Jens-Langen/letterbox/README.md

# letterbox
Smarter Briefkasten

Details: http://www.langen.koeln/wp/?p=11
