Jens-Langen/letterbox/Eagle/briefkasten_brd.png

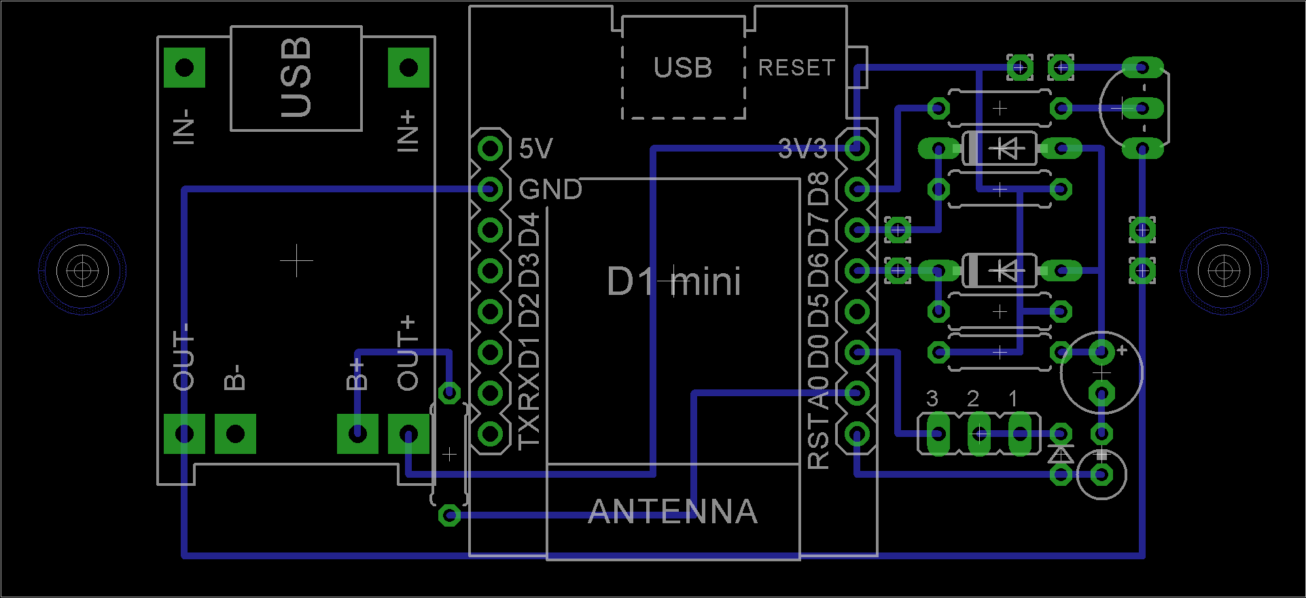
Eagle/briefkasten_brd.png
