Jens-Langen/letterbox/Eagle/briefkasten_sch.png

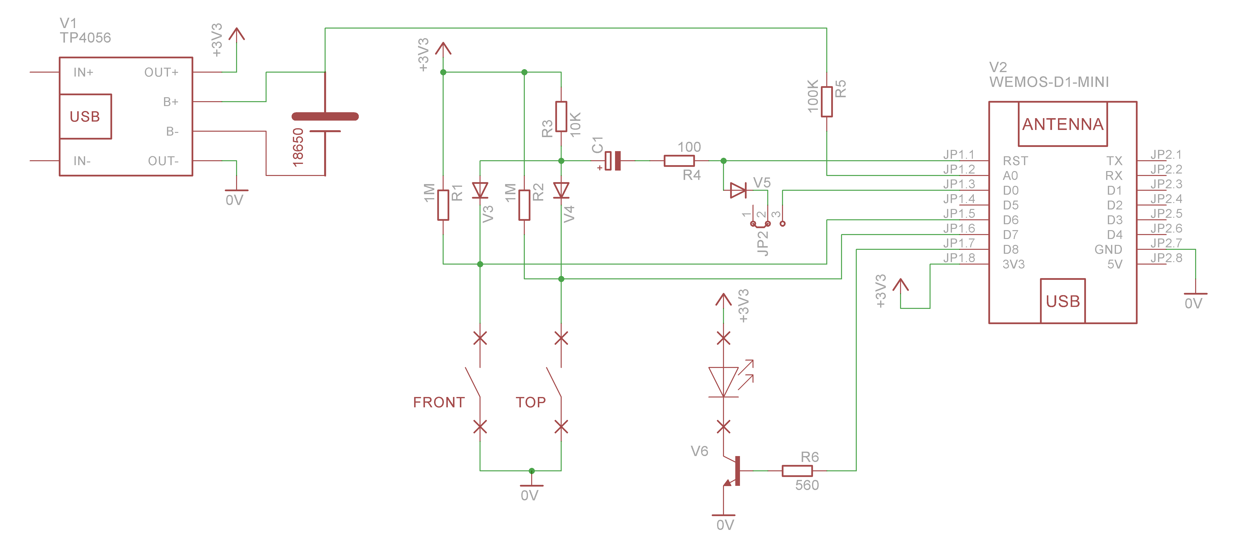
Eagle/briefkasten_sch.png
