Jens-Langen/letterbox/ioBroker/letter.gif

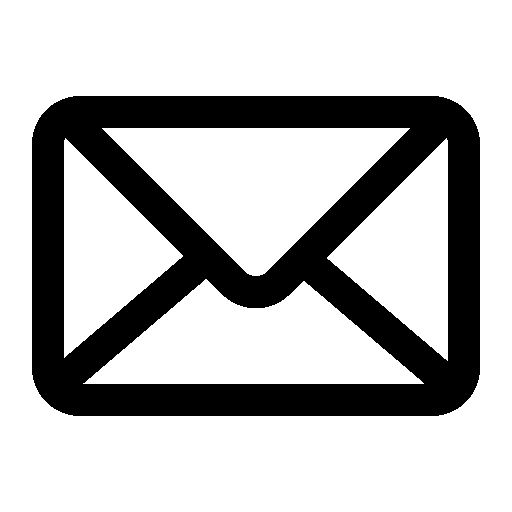
ioBroker/letter.gif
