Jens-Langen/letterbox/stl/bohr_lehre.stl

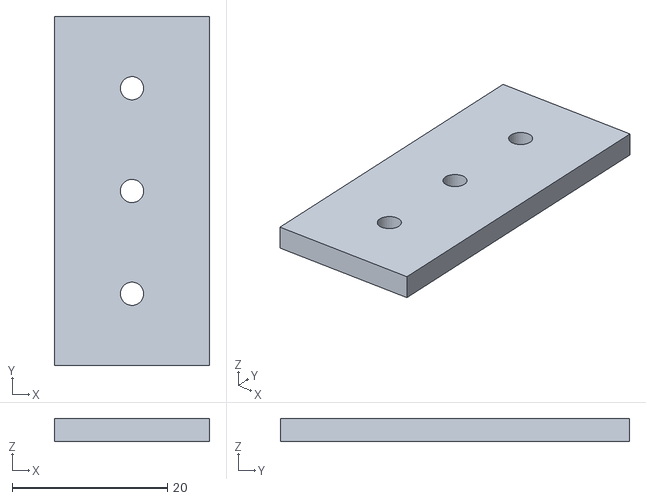
[picture p4: CAD file, 2019-02-04]
stl/bohr_lehre.stl
20.0 x 45.0 x 3.00
