Jens-Langen/letterbox/stl/Gehaeuse_unterteil.stl

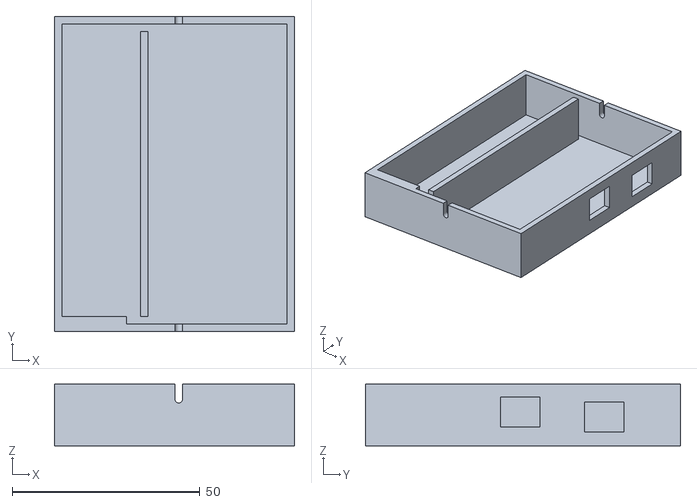
[picture p5: CAD file, 2019-02-04]
stl/Gehaeuse_unterteil.stl
64.0 x 84.0 x 16.4
