Jens-Langen/letterbox/stl/Stoessel.stl

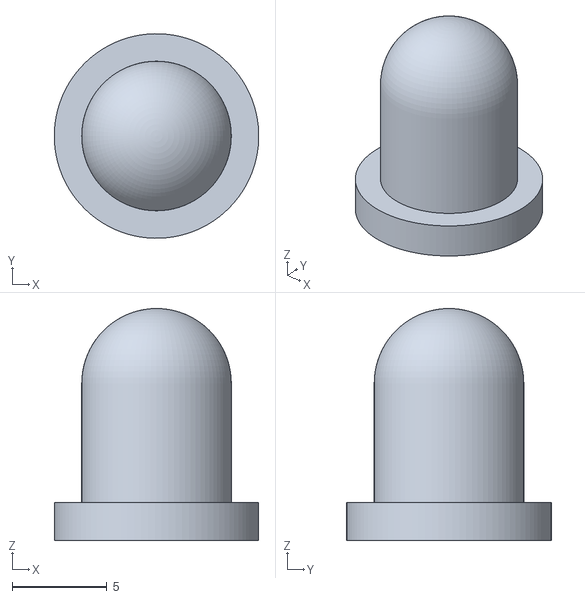
[picture p6: CAD file, 2019-02-04]
stl/Stoessel.stl
10.8 x 10.8 x 12.3
