Jens-Langen/letterbox/stl/Gehauese_deckel.stl

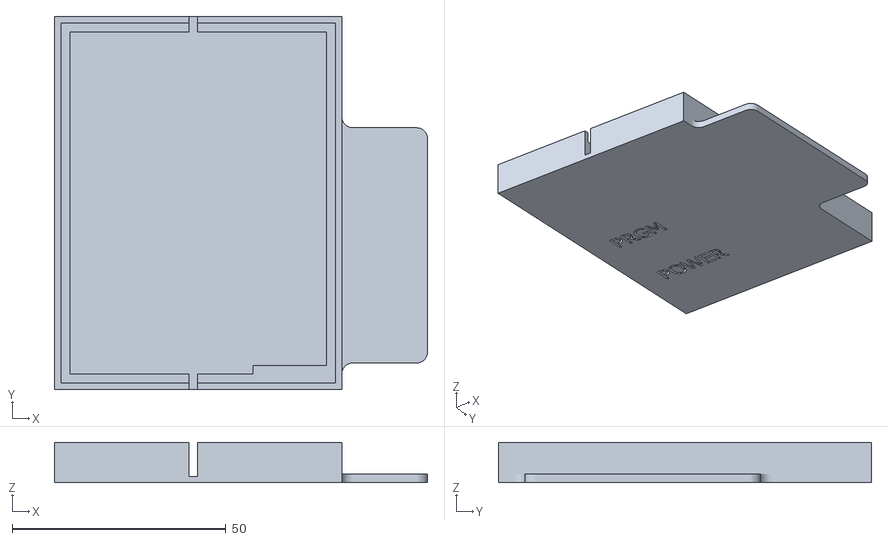
[picture p7: CAD file, 2019-02-04]
stl/Gehauese_deckel.stl
87.2 x 87.2 x 9.40
