Jens-Langen/letterbox/stl/halter2.stl

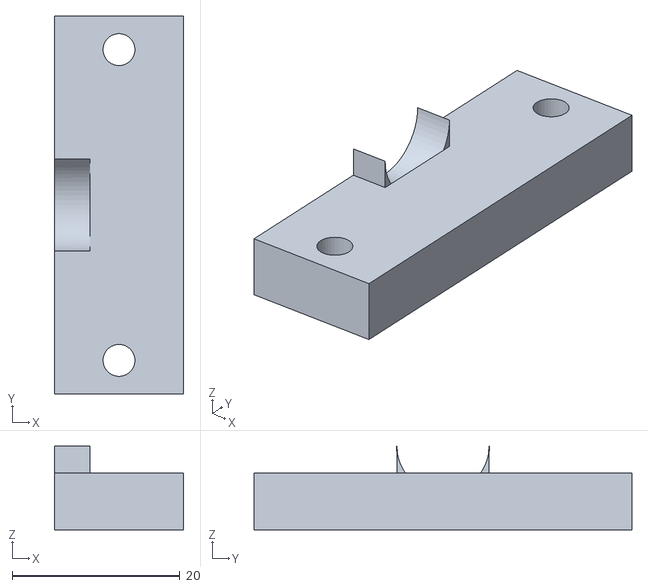
[picture p8: CAD file, 2019-02-04]
stl/halter2.stl
15.4 x 45.0 x 10.0
