Jens-Langen/letterbox/stl/schalter_Halter.stl

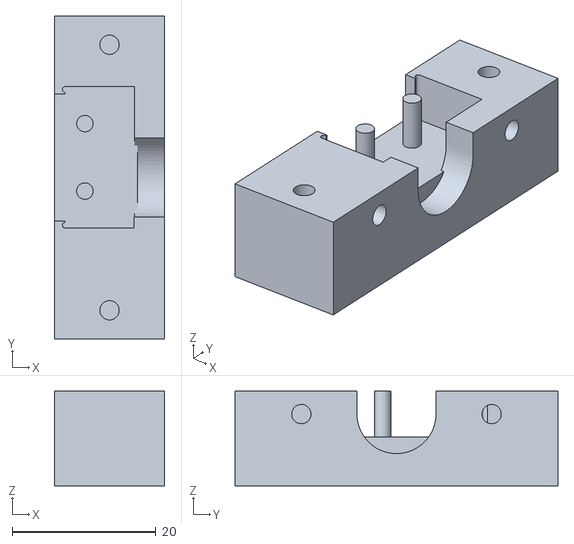
[picture p9: CAD file, 2019-02-04]
stl/schalter_Halter.stl
15.4 x 45.0 x 13.2
