Jens-Langen/letterbox/stl/deckel.stl

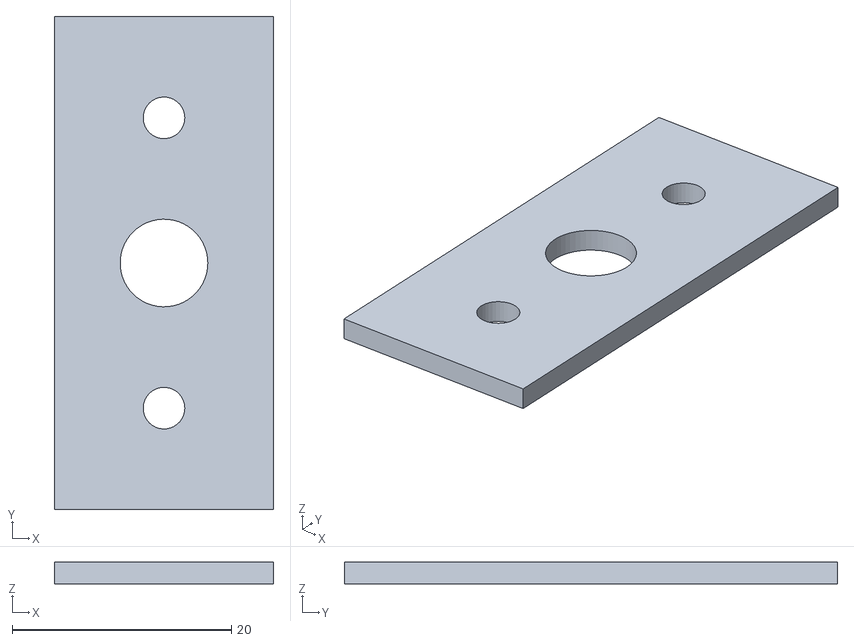
[picture p10: CAD file, 2019-02-04]
stl/deckel.stl
20.0 x 45.0 x 2.00
