Jens-Langen/letterbox/stl/abstandshalter.stl

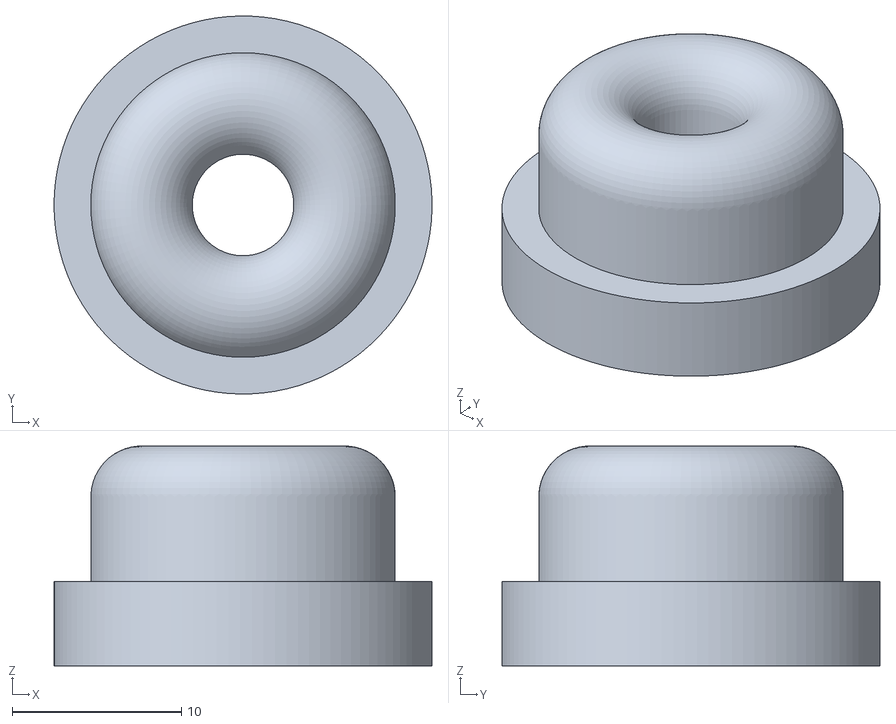
[picture p11: CAD file, 2019-02-04]
stl/abstandshalter.stl
22.3 x 22.3 x 13.0
