Jens-Langen/letterbox/Eagle/briefkasten.brd

## EAGLE design Eagle/briefkasten.brd (2019-02-04)

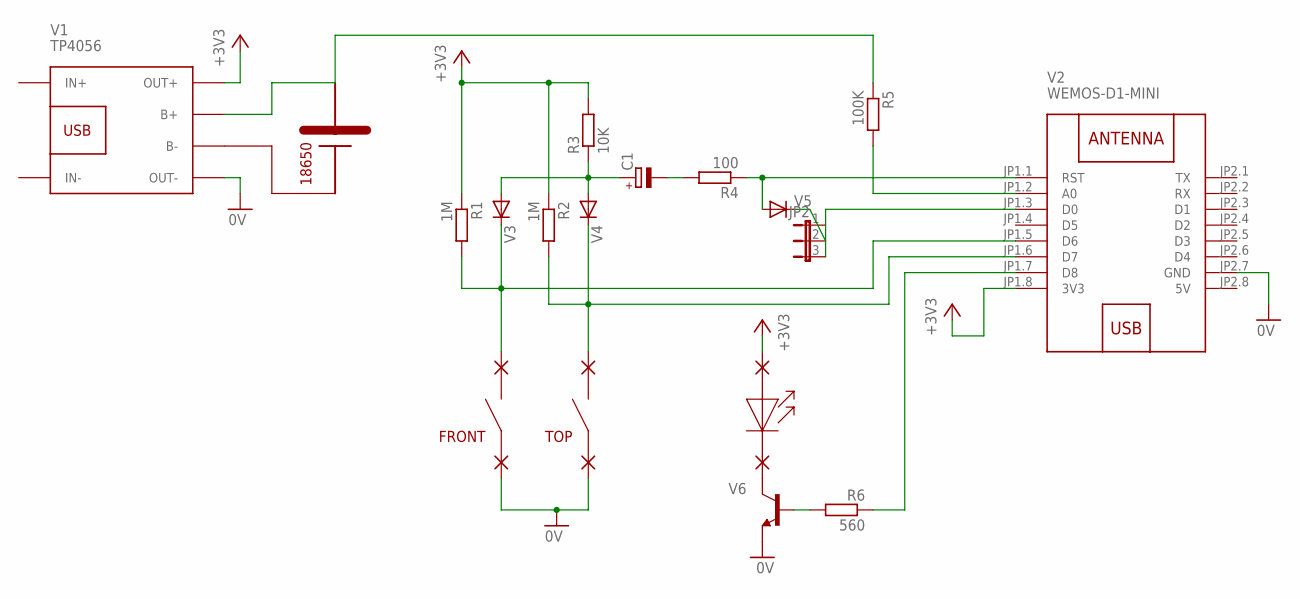
[picture p12: schematic briefkasten.sch]

Parts:
C1: CPOL-EUE2.5-5; E2,5-5
JP2: JP2E; JP2
PAD7, PAD8, PAD9, PAD10, PAD11, PAD12: 1,6/0,9
R1, R2: 1M; 0207/7
R3: 10K; 0207/7
R4: 100; 0309V
R5: 100K; 0207/7
R6: 560; 0207/7
V1: TP4056; BATTERY-CHARGER-LI-PROT
V2: WEMOS-D1-MINI
V3, V4: 1N4148DO35-7; DO35-7
V5: DIODE-D-2.5; D-2.5
V6: -NPN-TO92-EBC; TO92-EBC

Connections:
0V: PAD10.1, PAD12.1, V1.OUT-, V2.JP2.7 (GND), V6.E
5V: V2.JP2.8 (5V)
+3V3: PAD8.1, R1.1, R2.1, R3.2, V1.OUT+, V2.JP1.8 (3V3)
unnamed: PAD7.1, V6.C
unnamed: PAD11.1, R2.2, V2.JP1.6 (D7), V4.C
unnamed: C1.-, R4.2
unnamed: JP2.2, V5.C
unnamed: R4.1, V2.JP1.1 (RST), V5.A
unnamed: C1.+, R3.1, V3.A, V4.A
unnamed: R5.1, V1.B+
unnamed: PAD9.1, R1.2, V2.JP1.5 (D6), V3.C
unnamed: R5.2, V2.JP1.2 (A0)
unnamed: JP2.3, V2.JP1.3 (D0)
unnamed: R6.1, V2.JP1.7 (D8)
unnamed: R6.2, V6.B

Notes on the sheet:
18650
TOP
FRONT

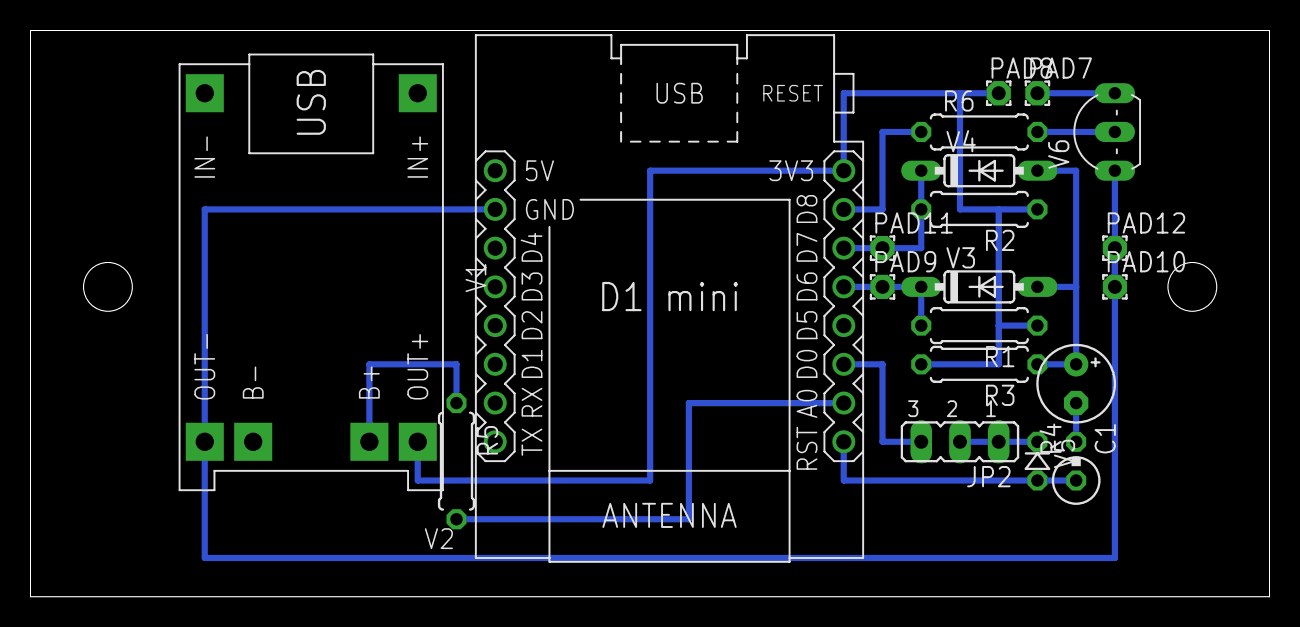
[picture p13: board briefkasten.brd from above]

Board: 2 copper layers, 81.3 x 37.1 mm, 20 parts (0 on the bottom side), 14 nets.
