Jens-Langen/letterbox/Arduino/src/main.cpp

/** The MIT License (MIT)

Copyright (c) 2019 Jens Langen

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
THE SOFTWARE IS PROVIDED "AS IS", WITHOUT WARRANTY OF ANY KIND, EXPRESS OR
IMPLIED, INCLUDING BUT NOT LIMITED TO THE WARRANTIES OF MERCHANTABILITY,
FITNESS FOR A PARTICULAR PURPOSE AND NONINFRINGEMENT. IN NO EVENT SHALL THE
AUTHORS OR COPYRIGHT HOLDERS BE LIABLE FOR ANY CLAIM, DAMAGES OR OTHER
LIABILITY, WHETHER IN AN ACTION OF CONTRACT, TORT OR OTHERWISE, ARISING FROM,
OUT OF OR IN CONNECTION WITH THE SOFTWARE OR THE USE OR OTHER DEALINGS IN THE
SOFTWARE.
*/

#include <Arduino.h>
#include <ESP8266WiFi.h>
#include <PubSubClient.h>

#include "settings.h"


WiFiClient espClient;
PubSubClient client(espClient);

String baseTopic = "LetterBox/";
String strTopicIP =  baseTopic + "INFO/IPADDRESS";
String strTopicTop =  baseTopic + "top_isOpen";
String strTopicFront =  baseTopic + "front_isOpen";
String strTopicBattery =  baseTopic + "battery";
  
String aliveTopic = baseTopic + "alive";

String strIP = "";
String clientId = "LetterBox";

bool stateTop = false;
bool stateFront = false;

#define LEDPIN LED_BUILTIN //  D8
#define top D7
#define front D6
#define LED D8


int batterySensor = A0;
bool firstData = true;
unsigned long previousMillis = 0;

void reconnect() {
  // Loop until we're reconnected
  while (!client.connected()) {
    Serial.print("Attempting MQTT connection...");
    // Create a random client ID
      clientId += String(random(0xffff), HEX);
    // Attempt to connect
    if (client.connect(clientId.c_str(), mqtt_user, mqtt_pwd )) {
      Serial.println("connected");
      // Once connected, publish an announcement...
      IPAddress localAddr = WiFi.localIP();
      byte oct1 = localAddr[0];
      byte oct2 = localAddr[1];
      byte oct3 = localAddr[2];
      byte oct4 = localAddr[3];
      char s[16];  
      sprintf(s, "%d.%d.%d.%d", oct1, oct2, oct3, oct4);
      
      client.publish(strTopicIP.c_str(), s ); 

      yield();

    } else {
      Serial.print("failed, rc=");
      Serial.print(client.state());
      Serial.println(" try again in 5 seconds");
      // Wait 5 seconds before retrying
      delay(5000);
    }
  }
}

void setup_wifi() {
    if (!WiFi.config(local_IP, gateway, subnet)) {
    Serial.println("STA Failed to configure");
  }

  Serial.print("Connecting to ");
  Serial.println(ssid);

  WiFi.begin(ssid, password);

  while (WiFi.status() != WL_CONNECTED) {
    delay(500);
    Serial.print(".");
    yield();
  }

  Serial.println("");
  Serial.println("WiFi connected!");
  Serial.print("IP address: ");
  Serial.println(WiFi.localIP());
  Serial.print("Subnet Mask: ");
  Serial.println(WiFi.subnetMask());
  Serial.print("Gateway IP: ");
  Serial.println(WiFi.gatewayIP());
  
  client.setServer(mqtt_server, mqtt_port);
}

void setup() {
  Serial.begin(115200);
  Serial.println("Start program");
  
  pinMode(LEDPIN,OUTPUT);
  digitalWrite(LEDPIN,false);
  
  pinMode(top, INPUT); 
  pinMode(front, INPUT);

  pinMode(LED,OUTPUT);
  digitalWrite(LED,false);
  stateTop = !digitalRead(top);
  stateFront = !digitalRead(front);
  
  if (stateFront) {
   digitalWrite(LED,true);
  }

  setup_wifi();


}

void loop() {
   
  if (!client.connected()) {
    reconnect();
  }
  client.loop();

  if ( firstData ) {
    Serial.println("First shot:");
    Serial.print("FRONT: ");
    Serial.println(stateFront);
    Serial.print("TOP  : ");
    Serial.println(stateTop);
    Serial.println("------------------------");
    client.publish(strTopicTop.c_str(), ( stateTop ? "1":"0" ) );
    client.publish(strTopicFront.c_str(), ( stateFront ? "1":"0" ) ); 
 
    unsigned int raw=0;
    float volt=0.0;
    
    raw = analogRead(batterySensor);
    volt = raw / 1023.0;
    String battery = String(volt*4.2);
    Serial.print("Battery:");
    Serial.println(battery);

    client.publish(strTopicBattery.c_str(), battery.c_str() );
    firstData = false;
        
  }

  

  if (millis() - previousMillis > 1000) {
    previousMillis = millis();

    stateTop = !digitalRead(top);
    stateFront = !digitalRead(front);
    Serial.print("FRONT: ");
    Serial.println(stateFront);
    Serial.print("TOP  : ");
    Serial.println(stateTop);
    Serial.println("------------------------");
        
    if (stateFront == false && stateTop == false) {
      client.publish(strTopicTop.c_str(), ( stateTop ? "1":"0" ) );
      client.publish(strTopicFront.c_str(), ( stateFront ? "1":"0" ) ); 

      delay(2000);
      digitalWrite(LED,false);
      Serial.println("Sleep");
      // set max sleeptime
      system_deep_sleep(4294967295);
    }

    yield();
  }  
 
 
}
