Jens-Langen/letterbox/(commit log)

2019-02-05 fast opening send fail state
    [main.cpp]
2020-05-20 Only the top button was send
